QuadState/ECmacro/hardware/4H/ECmacro-4H.kicad_pcb

## KiCad design hardware/4H/ECmacro-4H.kicad_pcb (2026-10-22)

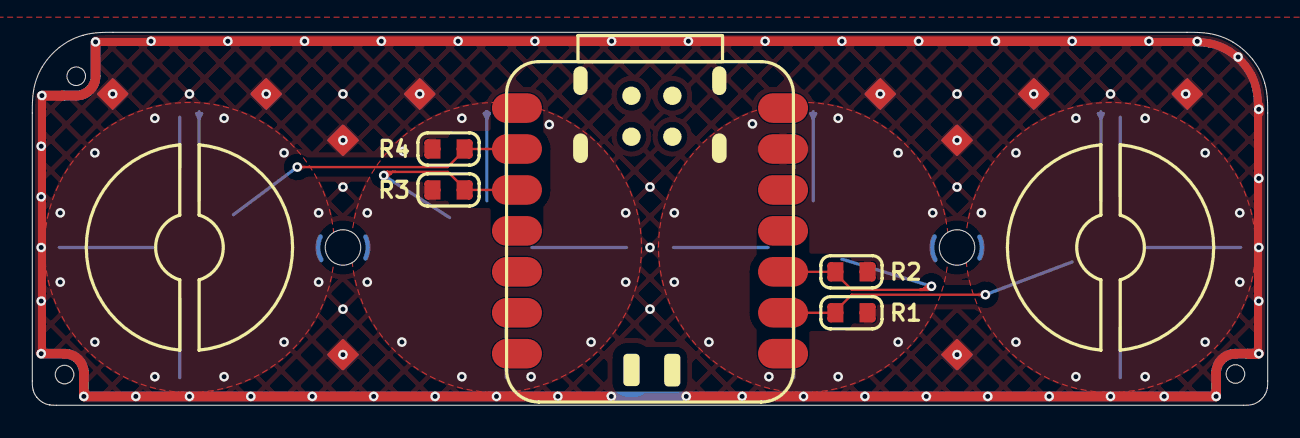
[picture p3: board ECmacro-4H.kicad_pcb from above]

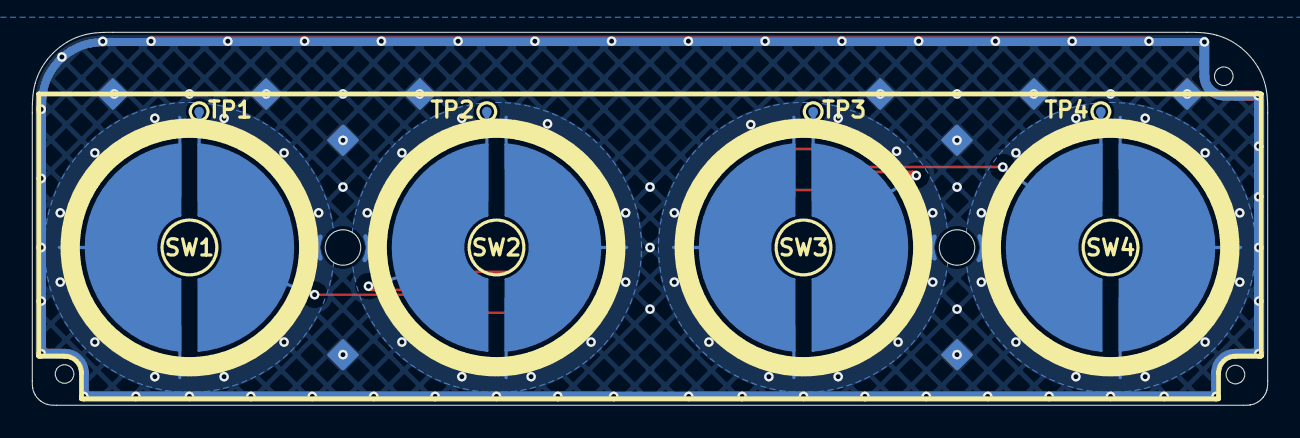
[picture p4: board ECmacro-4H.kicad_pcb from below]

Board: 2 copper layers, 76.7 x 23.1 mm, 18 parts (8 on the bottom side), 5 nets.

Parts:
R1, R2, R3, R4: 680kΩ; R_SMD_2012
SW1, SW2, SW3, SW4: SW_Cap; CapacitiveSwitch_16mm
TH1, TH2, TH3: ToolingHole_1.152mm
TH4, TH5: MountingHole_2.2mm_M2
TP1, TP2, TP3, TP4: TestPoint; TestPoint_Pad_D0.6mm
U2: XIAO RP2040; Module_XIAO_RP2040

Connections:
/SW1: R1.1, SW1.2, TP1.1 (1_1), U2.9 (D8)
/SW2: R2.1, SW2.1, TP2.1 (1_1), U2.10 (D9)
/SW3: R3.1, SW3.1, TP3.1 (1_1), U2.3 (D2)
/SW4: R4.1, SW4.1, TP4.1 (1_1), U2.2 (D1)
GND: R1.2, R2.2, R3.2, R4.2, SW1.1, SW2.2, SW3.2, SW4.2, U2.13 (GND)
