QuadState/ECmacro/hardware/2V/ECmacro-2V.kicad_pcb

## KiCad design hardware/2V/ECmacro-2V.kicad_pcb (2026-10-17)

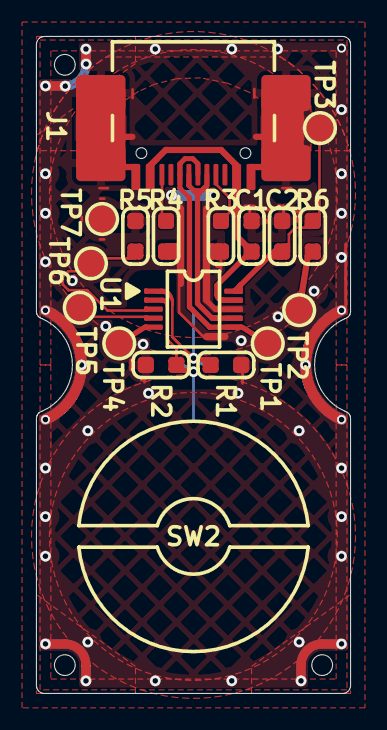
[picture p5: board ECmacro-2V.kicad_pcb from above]

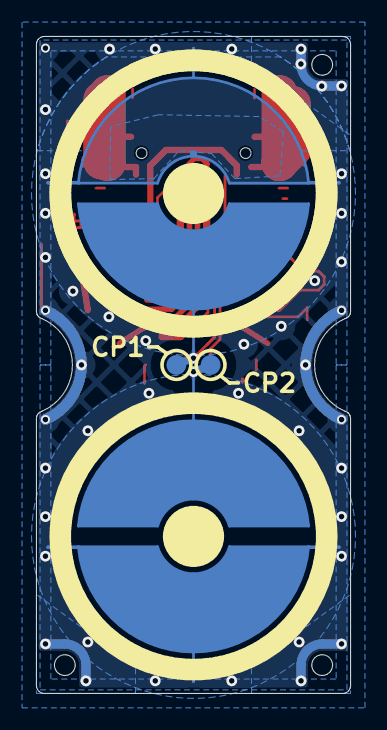
[picture p6: board ECmacro-2V.kicad_pcb from below]

Board: 2 copper layers, 17.4 x 36.5 mm, 37 parts (12 on the bottom side), 13 nets.

Parts:
C1, C2: 0.1u; R_0603_1608Metric
CP1, CP2: TestPoint; TestPoint_Pad1.1mm_Mask0.8mm
Dummy1, Dummy2, Dummy3, Dummy5: Keepout_QuarterCircle_R0.5mm
Dummy4: Keepout_QuarterCircle_R1.0mm
Dummy6, Dummy7: Keepout_Circle_D3.0mm
Dummy8, Dummy9, Dummy10: ToolingHole_1.152mm
J1: USB_C_Receptacle_USB2.0_14P; USB_C_Receptacle_USB2.0_SMD
R1, R2: 2MΩ; R_0603_1608Metric
R3, R4: 5.1kΩ; R_0603_1608Metric
R5, R6: 10kΩ; R_0603_1608Metric
SW1: SW_Cap; CapacitiveSwitch_16mm_SplitKeepout
SW2: SW_Cap; CapacitiveSwitch_16mm
SW3, SW6: SW_Cap; CapacitiveSwitch_16mm_Trace_Left
SW4, SW8: SW_Cap; CapacitiveSwitch_16mm_Trace_Center
SW5, SW7: SW_Cap; CapacitiveSwitch_16mm_Trace_Right
TP1, TP2, TP3, TP4, TP5, TP6, TP7: TestPoint; TestPoint_Pad1.5mm_Mask1.2mm
U1: CH552E; IC_MSOP10_3x3mm_P0.5mm

Connections:
/D+: J1.A6 (D+), J1.B6 (D+), TP1.1, U1.6 (P3.6)
/D-: J1.A7 (D-), J1.B7 (D-), U1.7 (P3.7)
/SW1: CP1.1, R1.1, SW1.2, U1.1 (P1.4)
/SW2: CP2.1, R2.1, SW2.1, U1.2 (P1.5)
/TX: TP5.1, U1.4 (P1.7)
/VBUS: C1.1, J1.A4 (VBUS), J1.A9 (VBUS), J1.B4 (VBUS), J1.B9 (VBUS), U1.9 (VDD)
GND: C1.2, C2.2, J1.A1 (GND), J1.A12 (GND), J1.B1 (GND), J1.B12 (GND), J1.S1 (SHIELD), R1.2, R2.2, R3.2, R4.2, R5.1, SW1.1, SW2.2, SW3.1, SW4.1, SW5.1, SW6.1, SW7.1, SW8.1, TP7.1, U1.8 (GND)
unnamed: J1.A5 (CC1), R3.1
unnamed: J1.B5 (CC2), R4.1
unnamed: R6.2, TP2.1
unnamed: R5.2, TP6.1, U1.3 (P1.6)
unnamed: TP4.1, U1.5 (RST)
unnamed: C2.1, R6.1, TP3.1, U1.10 (V33)
