QuadState/ECmacro/(commit log)

2026-10-17 ECmacro 2V
2026-11-07 4H: the firmware's license, source and third-party notices in the repository; Remap
    firmware/rp2040/THIRD-PARTY-NOTICES.txt gives the license of the firmware written
    on the ECmacro 4H, where to get its complete source code, how to build and install
    it, and its third-party notices; the README and LICENSE link to it. The README and
    the udev rule's comment name Remap, where the 4H is now registered, and the README
    describes the switch parts in general terms. The firmware and the tag 4h-v1.0.0
    are unchanged.
